DMGithinji/Smart-Shopping-Cart/Electrical Circuit Designs/Shopping cart circuit board designs/Power supply+tracking+obstacle avoidance.sch.pdf

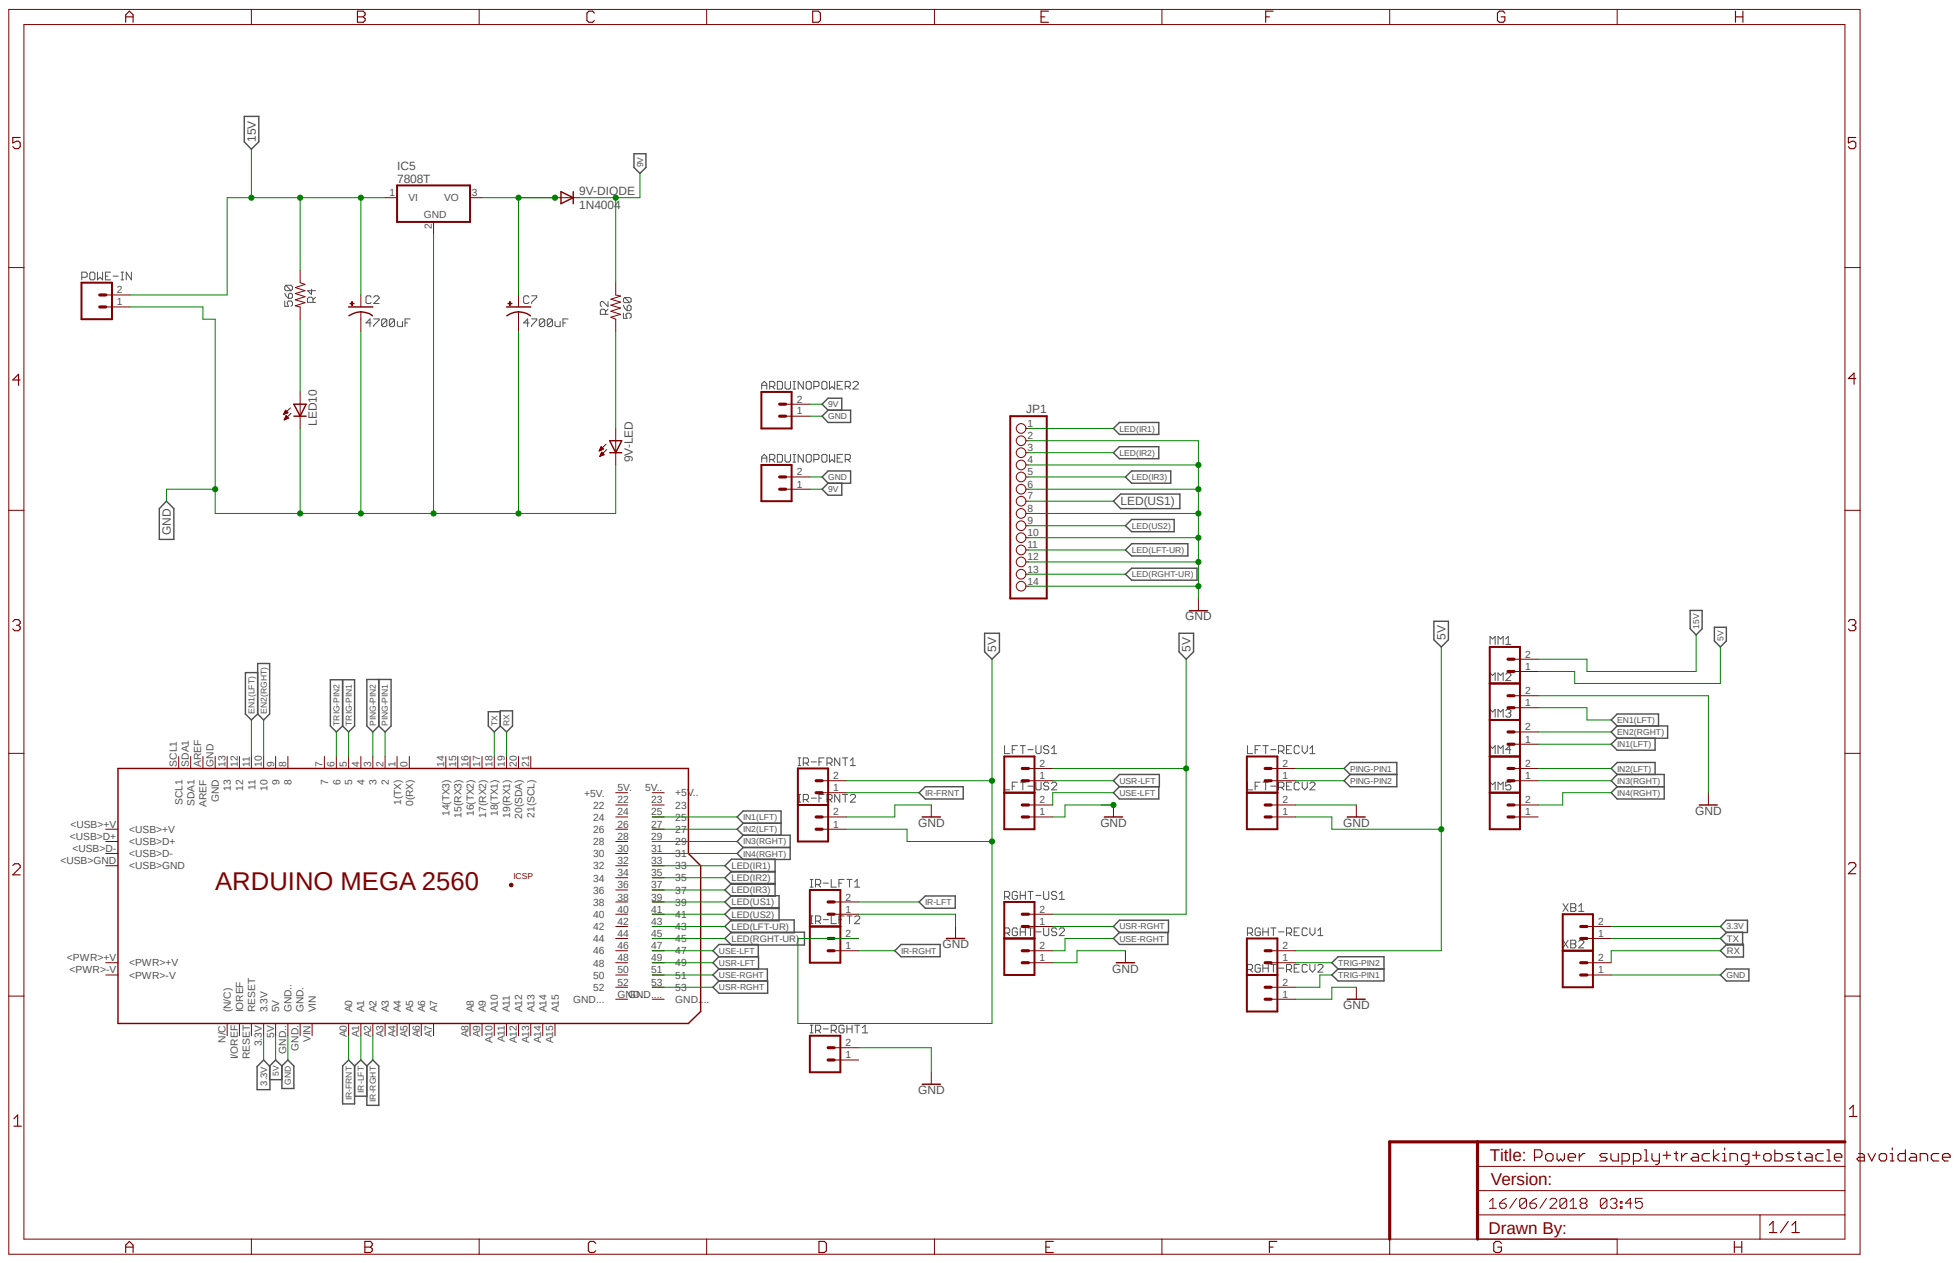
[picture p51: page 1]
GND; 9V-LED; SCL1 SCL1; SDA1 SDA1; AREF AREF GND GND 13 13; <PWR>-V <PWR>-V; <PWR>+V <PWR>+V; <USB>GND <USB>GND; <USB>D- <USB>D-; <USB>D+ <USB>D+; <USB>+V <USB>+V; 20(SDA) 20; 21(SCL) 21; GND.... GND.... GND...; GND... 52; LED10; 9V-DIODE; IR-FRNT; IR-LFT; USR-RGHT USE-RGHT; USR-LFT USE-LFT; LED(US2); LED(US1); LED(IR1); LED(IR2); IN1(LFT); IN2(LFT) IN3(RGHT); LED(IR3); IN4(RGHT); EN2(RGHT); IR-RGHT; EN1(LFT); PING-PIN1; PING-PIN2; TRIG-PIN1; TRIG-PIN2; ARDUINO MEGA 2560; ICSP; Drawn By: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

LED(LFT-UR)

LED(RGHT-UR)

IN1(LFT)
IN2(LFT)
IN3(RGHT)
IN4(RGHT)
LED(IR1)
LED(IR2)
LED(IR3)
LED(US1)
LED(US2)
USE-LFT
USR-LFT
USE-RGHT
USR-RGHT

VIN VIN GND. GND. GND.. GND.. 5V 5V 3.3V 3.3V RESET RESET IOREF I/OREF (N/C) N/C
