DMGithinji/Smart-Shopping-Cart/Electrical Circuit Designs/Tracker Circuit/Tracker-100.brd.pdf

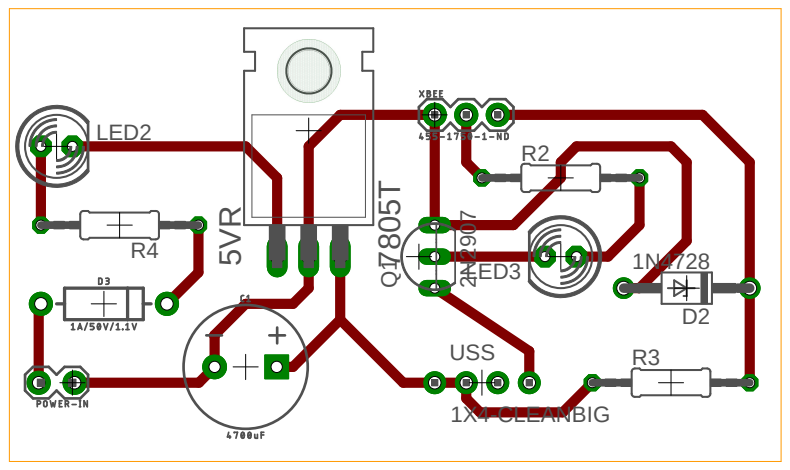
[picture p52: page 1]
LED2; LED3; USS; 1X4-CLEANBIG
