DMGithinji/Smart-Shopping-Cart/Electrical Circuit Designs/Tracker Circuit/Tracker-100.sch.pdf

# GND¹N⁴⁷²⁸

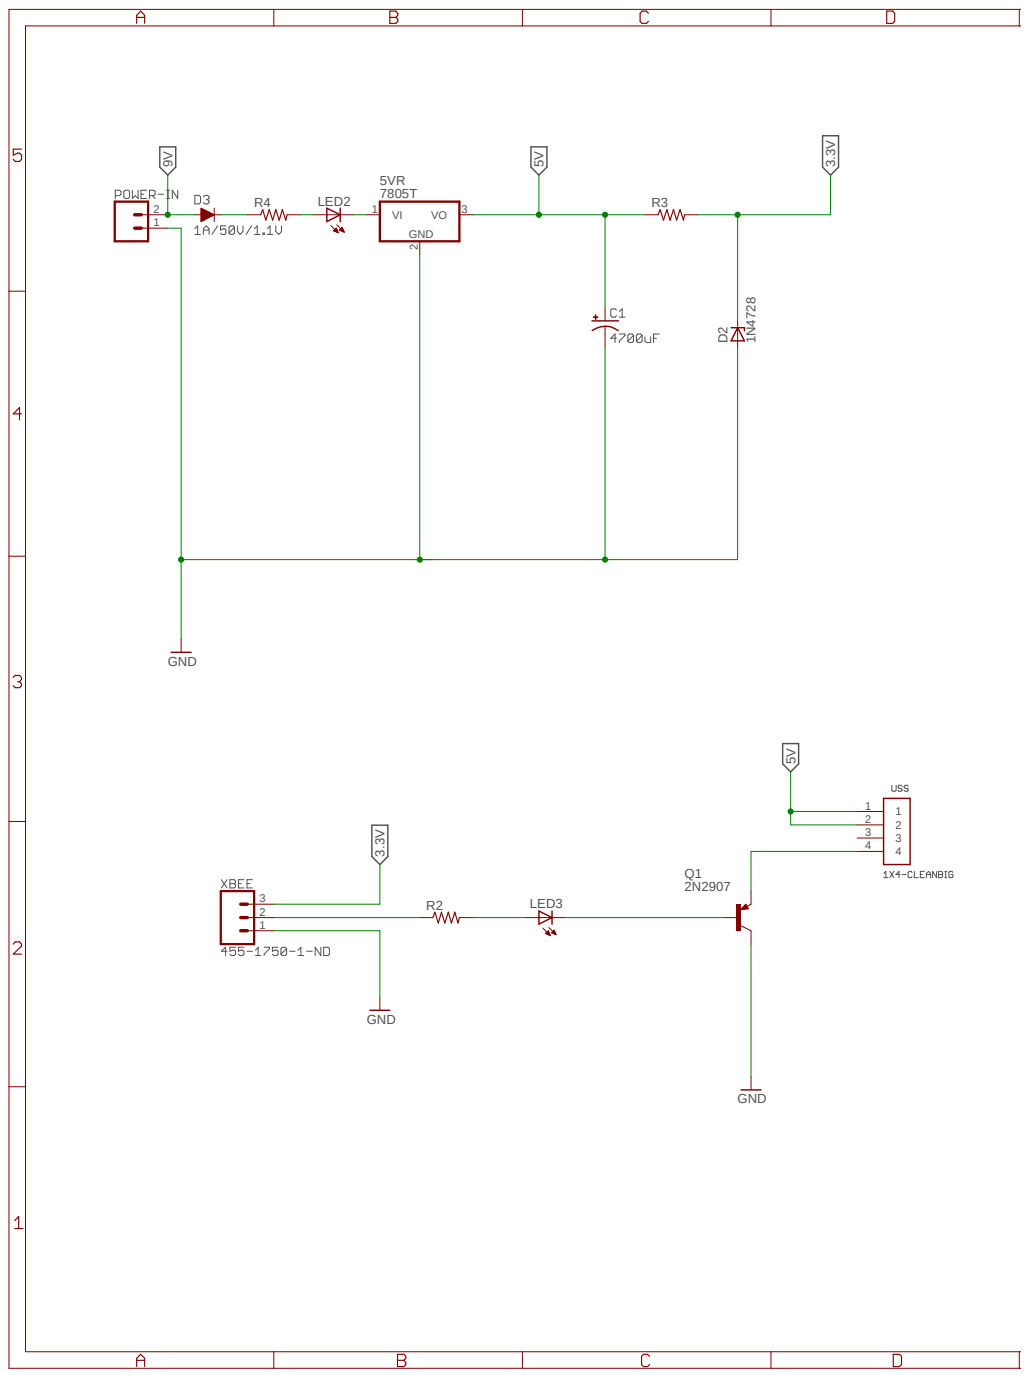
[picture p53: page 1]
GND; LED2; LED3

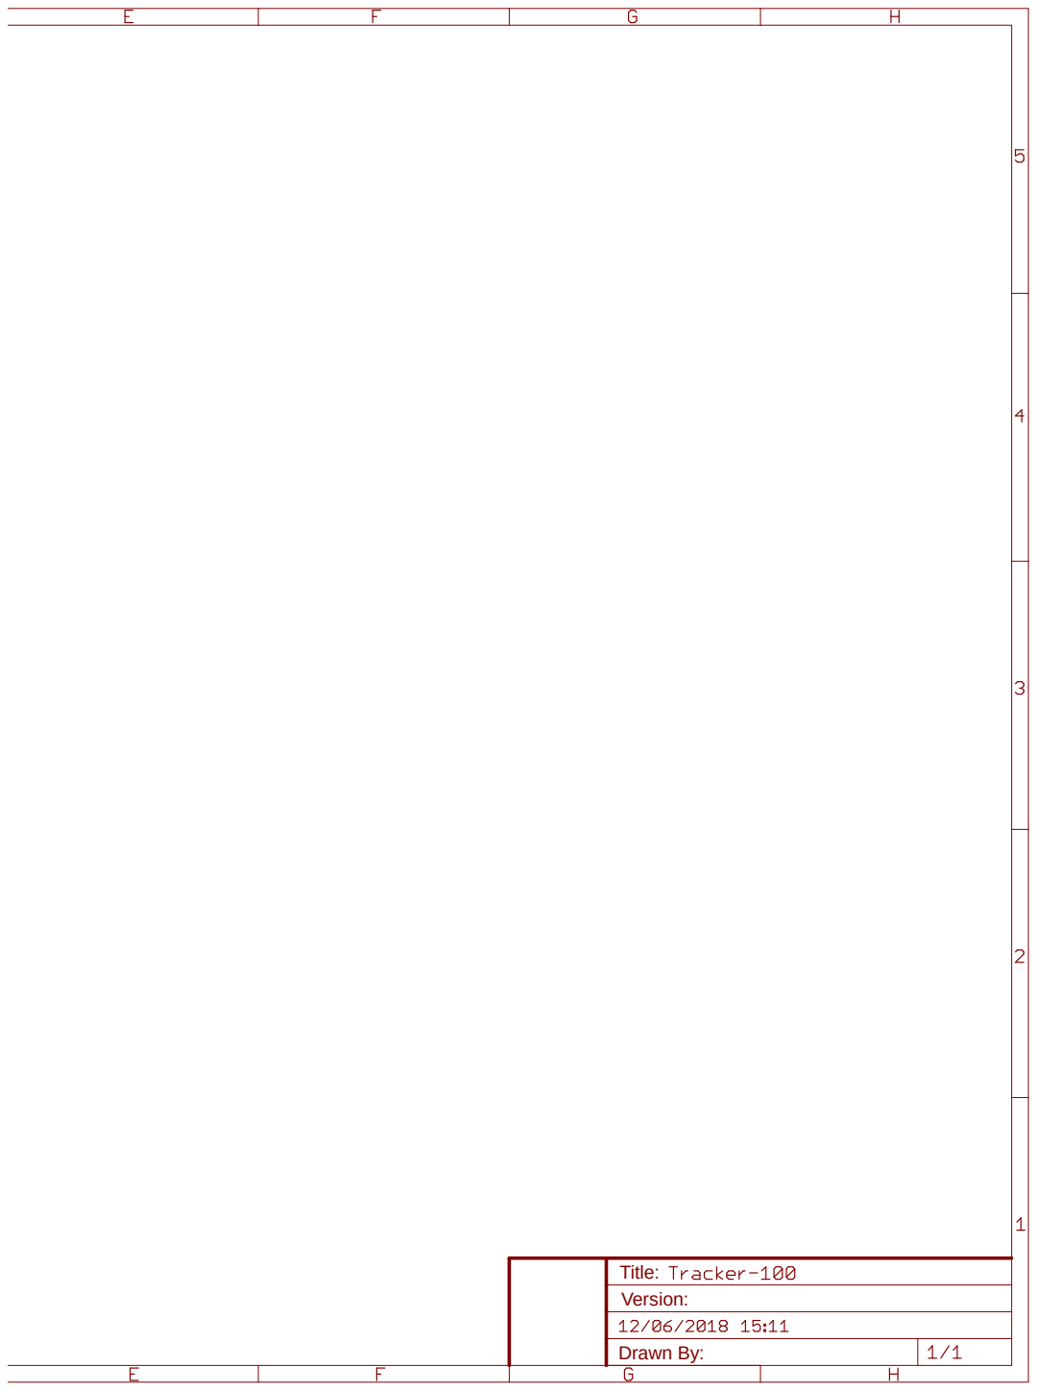
[picture p54: figure]
Drawn By:; Title: Version:
