DMGithinji/Smart-Shopping-Cart/Electrical Circuit Designs/Shopping cart circuit board designs/Monster moto shield.brd.pdf

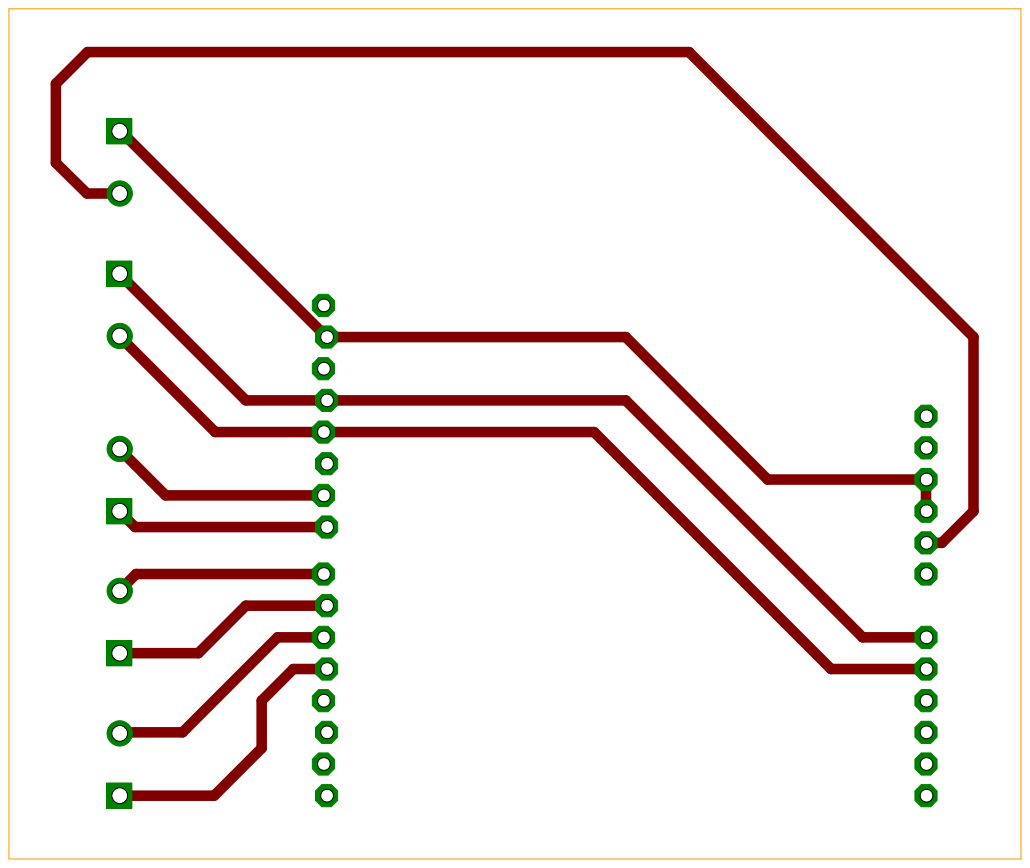
[picture p55: page 1]
