DMGithinji/Smart-Shopping-Cart/Electrical Circuit Designs/Shopping cart circuit board designs/Power supply+tracking+obstacle avoidance.brd.pdf

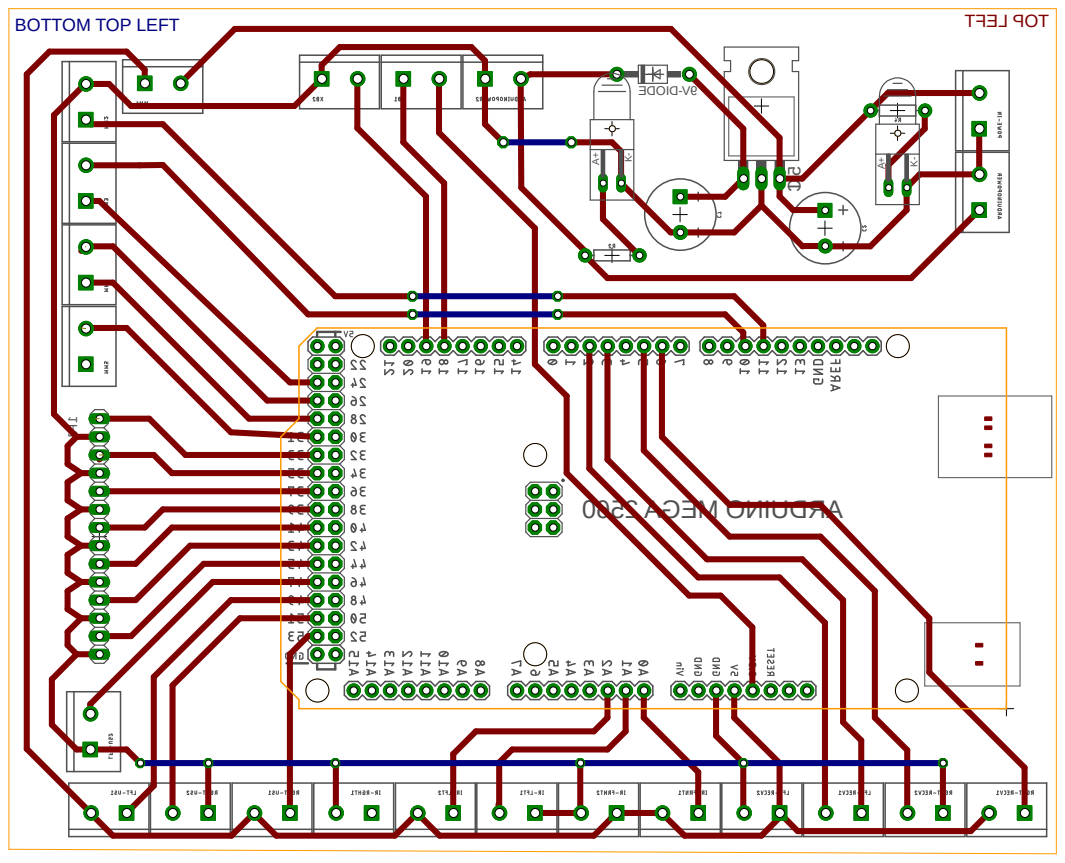
[picture p56: page 1]
BOTTOM TOP LEFT; TOP LEFT A⁺
