DMGithinji/Smart-Shopping-Cart/Electrical Circuit Designs/Tracker Circuit/Tracker working circuit.brd.pdf

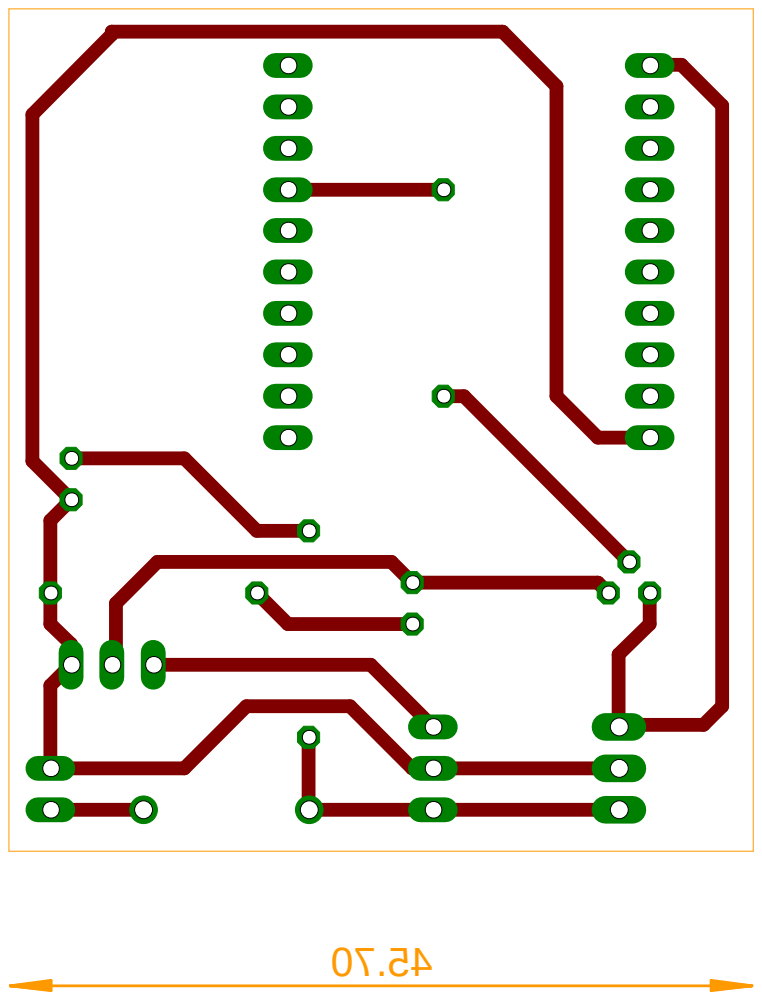
[picture p57: page 1]
